jmpinit/greyport/Documentation/Keyboard/kb_assembled_f.jpg

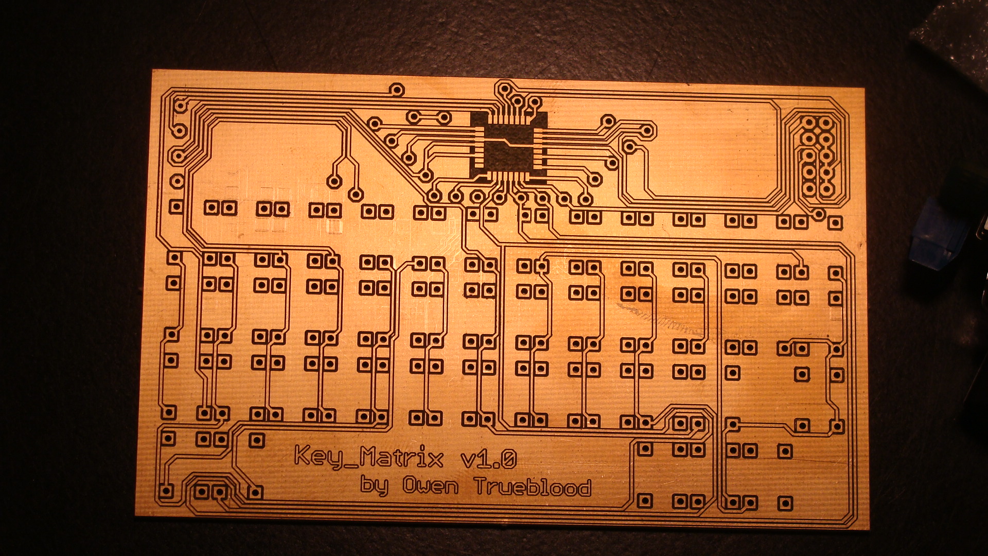
Documentation/Keyboard/kb_assembled_f.jpg
