jmpinit/greyport/Documentation/TFT LCD/TFT LCD Pinout.png

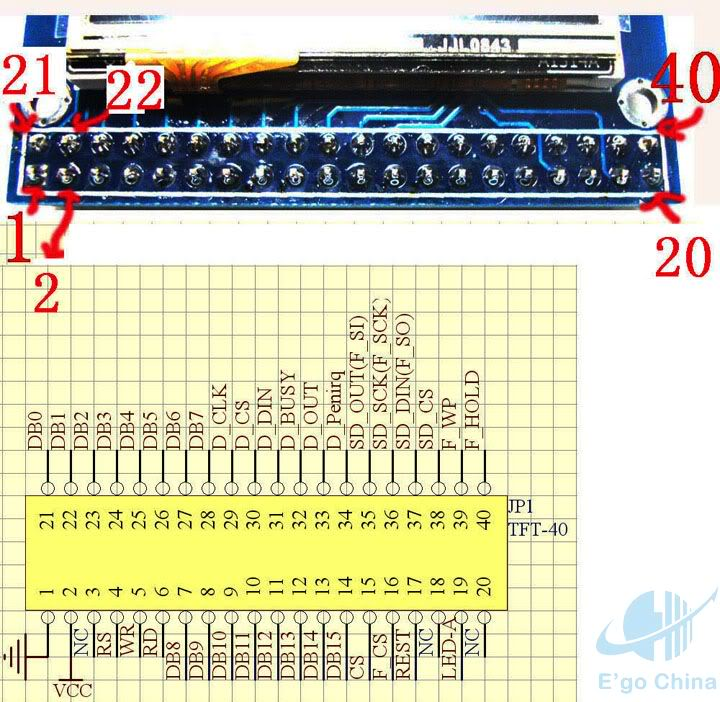
Documentation/TFT LCD/TFT LCD Pinout.png
