jmpinit/greyport/Documentation/Keyboard/IMG_0002.jpg

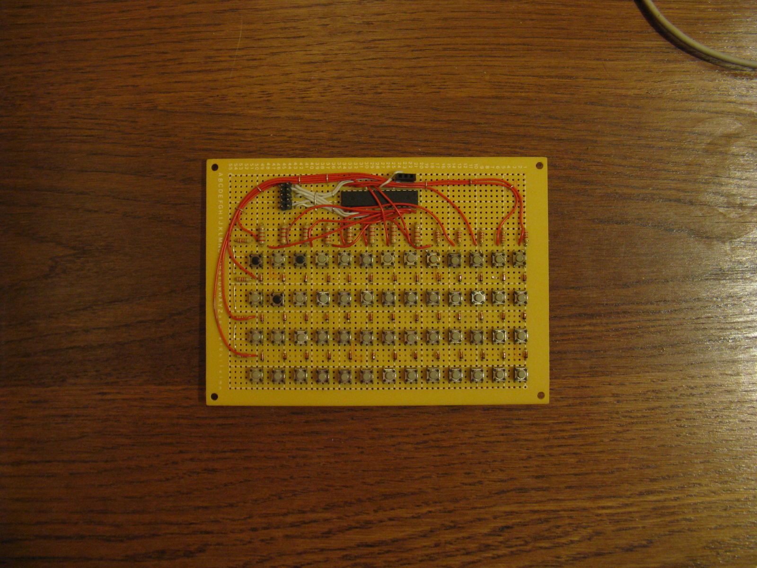
Documentation/Keyboard/IMG_0002.jpg
