jmpinit/greyport/Documentation/Keyboard/matrix_example.bmp

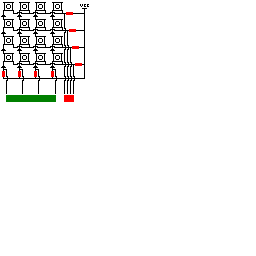
Documentation/Keyboard/matrix_example.bmp
