jmpinit/greyport/Documentation/Keyboard/P1010155.JPG

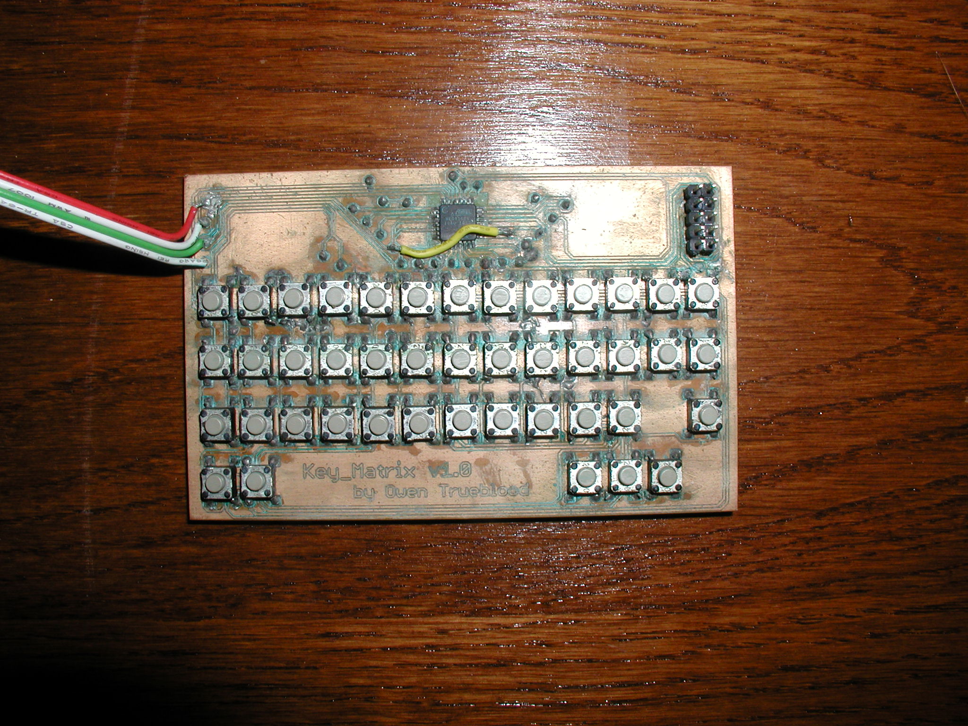
Documentation/Keyboard/P1010155.JPG
