jmpinit/greyport/Documentation/Keyboard/P1010156.JPG

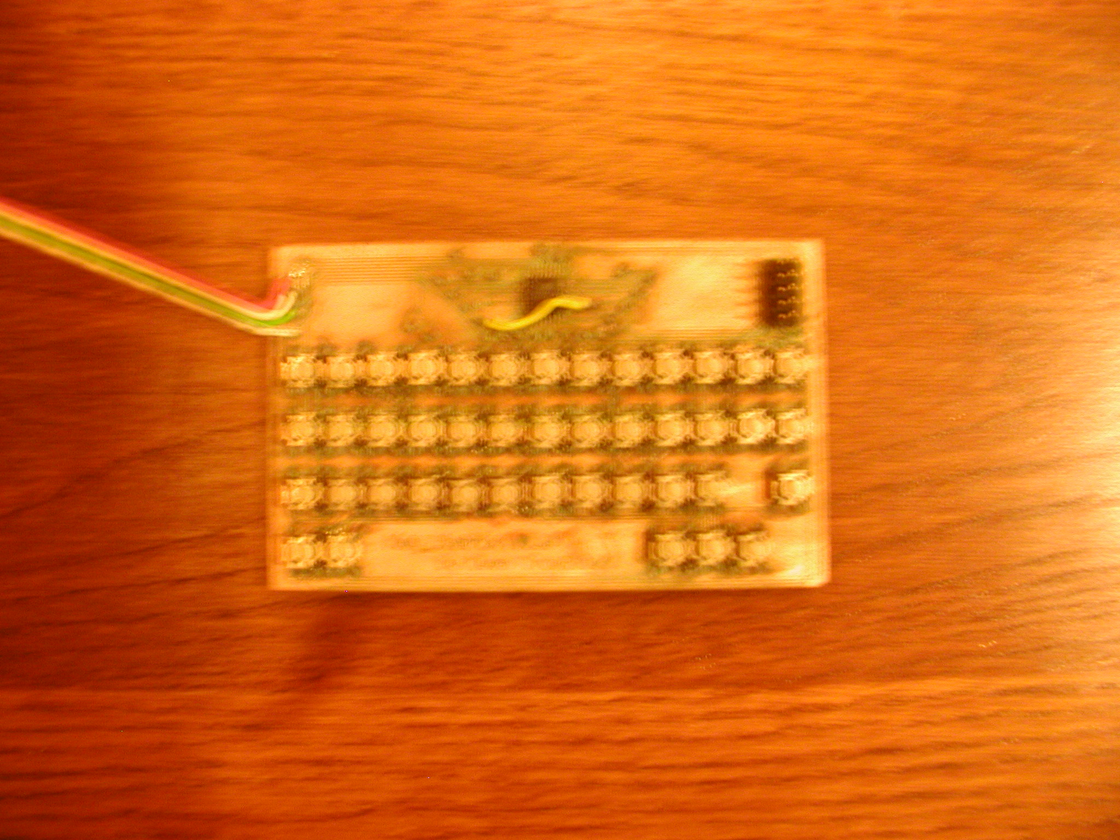
Documentation/Keyboard/P1010156.JPG
