jmpinit/greyport/Documentation/Keyboard/P1010157.JPG

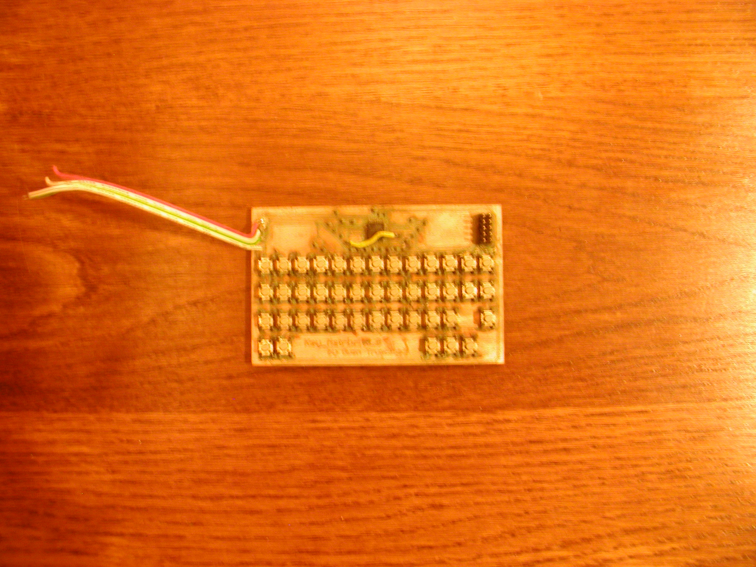
Documentation/Keyboard/P1010157.JPG
