jmpinit/greyport/Documentation/Keyboard/protokeyboard.JPG

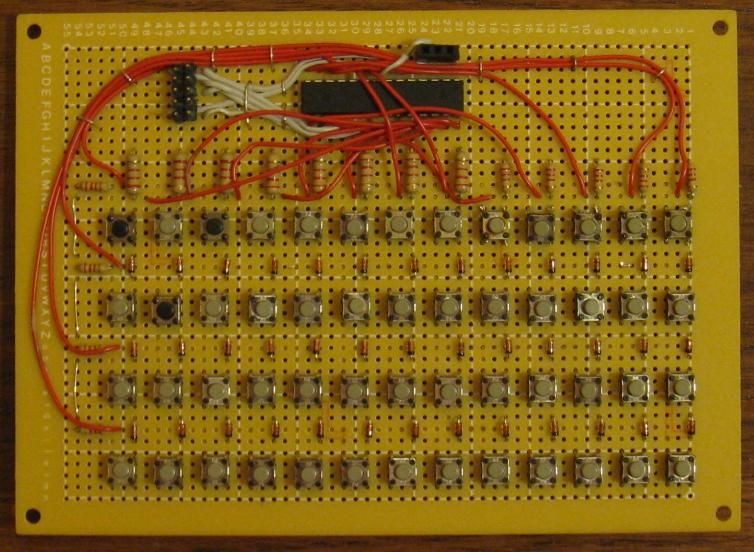
Documentation/Keyboard/protokeyboard.JPG
