jmpinit/greyport/Documentation/Prototype/Boarded.jpg

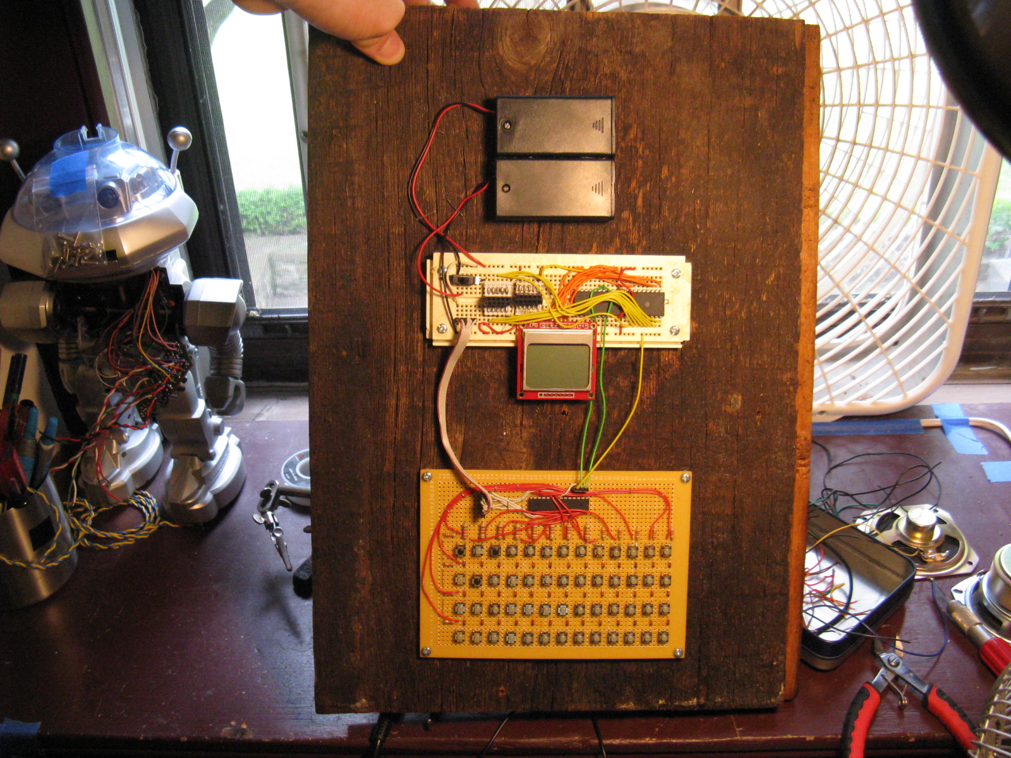
Documentation/Prototype/Boarded.jpg
