jmpinit/greyport/Documentation/Prototype/IMG_0042.JPG

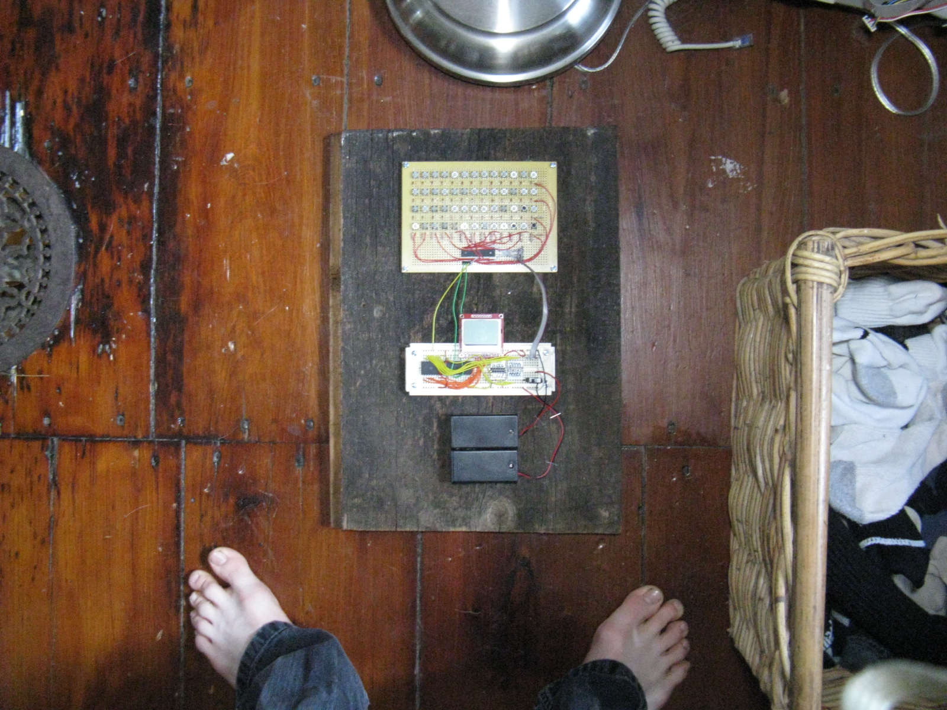
Documentation/Prototype/IMG_0042.JPG
