jmpinit/greyport/Documentation/Prototype/IMG_0043.JPG

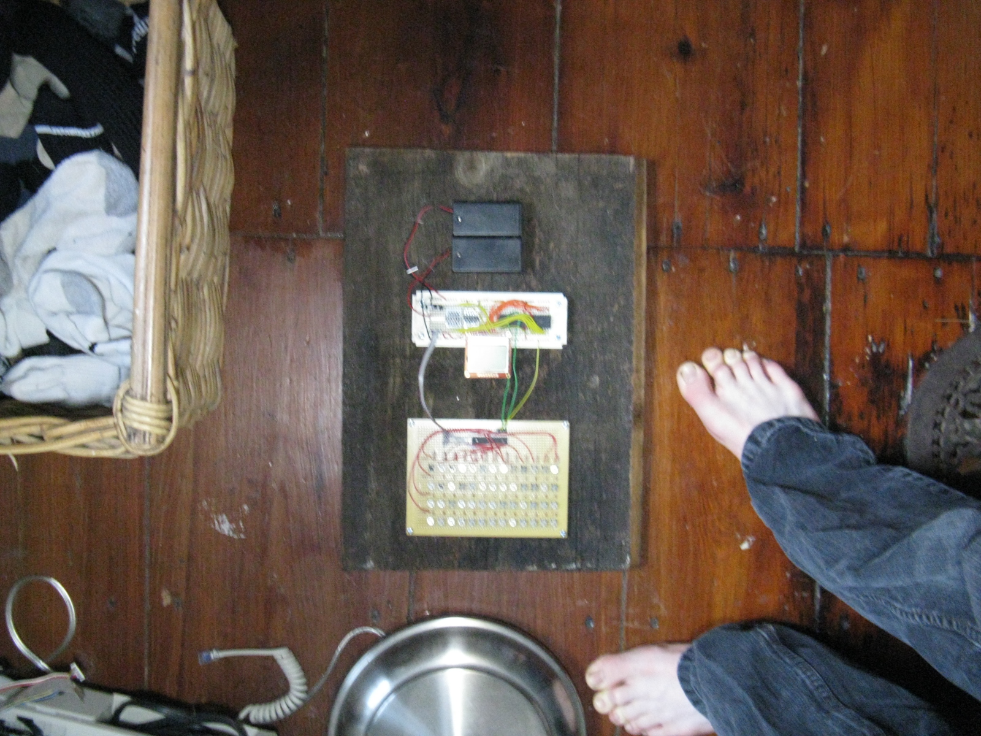
Documentation/Prototype/IMG_0043.JPG
