jmpinit/greyport/Documentation/Prototype/IMG_0044.JPG

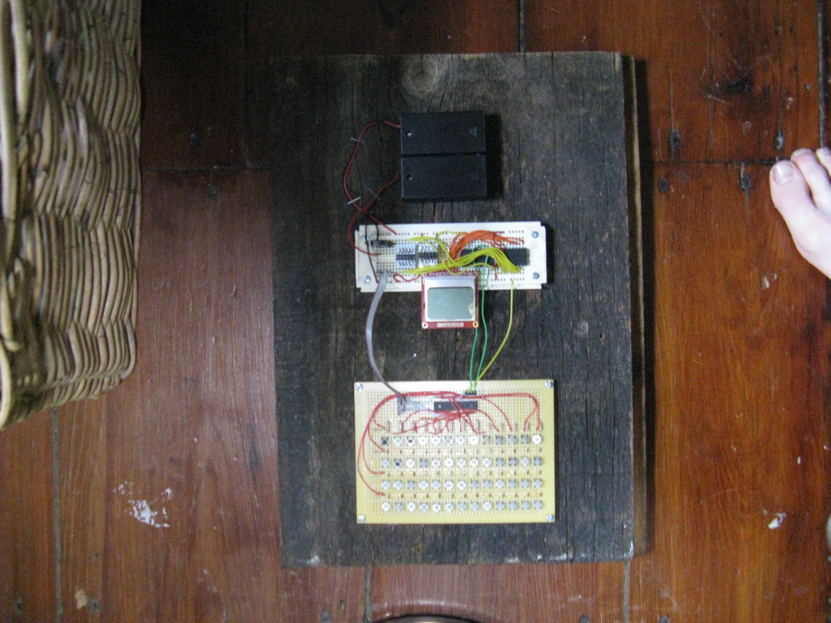
Documentation/Prototype/IMG_0044.JPG
