jmpinit/greyport/Documentation/Prototype/IMG_0046.JPG

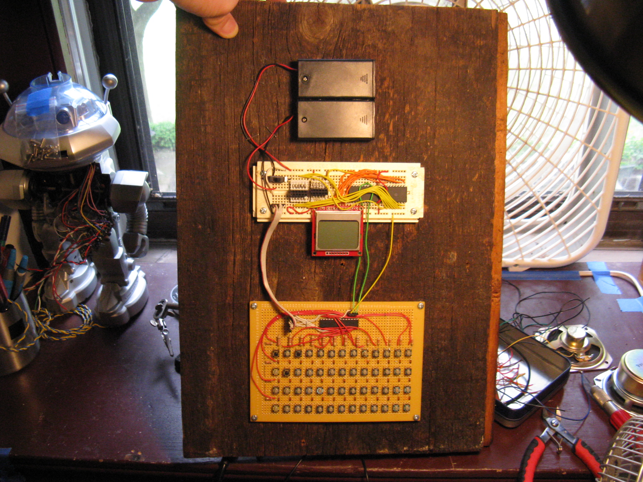
Documentation/Prototype/IMG_0046.JPG
