jmpinit/greyport/(list of files, cad)

Other CAD files:
Code/Tests/System/interpreter/interpreter.obj
Code/Tests/TFT LCD/lcd_characters/lcd_characters.obj
Code/Tests/TFT LCD/lcd_test/lcd_test.obj
Code/Firmware/Keyboard/firmware_v1/firmware_v1.obj
