jmpinit/greyport/Code/Firmware/Basic/OS 0.5/keyboard.c

#include "keyboard.h"

*char get_all_keys()
{
	return state;
}

*char last_all_keys()
{
	return state;
}

char get_key()
{
	return key;
}

char last_key()
{
	return key;
}

char decode_key(char index)
{
	return code;
}
