jmpinit/greyport/Code/Firmware/Proto/OS 0.1/Editor.h

/*//26 letter variables
//operator tokens
//function tokens

void editor_run(void);
void render(void);

void inc_line(void);
void dec_line(void);

void print_tok(unsigned char val, unsigned char type);
void print_cmd(unsigned char cmd);
void print_hex(unsigned char val);
void print_var(unsigned char var);
void print_func(unsigned char func);

unsigned char get_type(unsigned char pos, unsigned char param);

void insert_tok(int pos, unsigned char val);
void delete_tok(int pos);*/
